IsaacHook/Oscilloscope/README.md

# Oscilloscope
Schematic, PCB, simulation results, firmware and outputs for 20MHz oscilloscope.

#### Front End Desgin
Specification was for an anti-aliasing filter suitable for the 40MSPS maximum sample rate. 
To be implemented with a minimum of a first-order 20dB per decade response and ±2dB maximum ripple in the pass band.
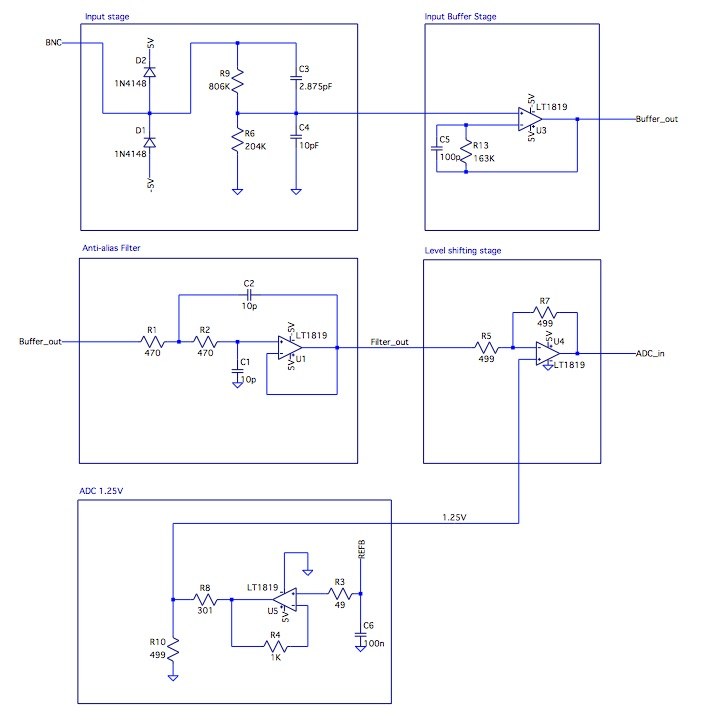
[picture p1: Frontend/frontend.jpg]
  
The plot below shows these specifications were satisfied. A flat response (-13.8 to -13.7dB) can be seen in the pass band, giving a ripple of less than 2dB. 
The 3dB cut-off point is at 20Mhz (-16.5dB) allowing for a maximum sampling rate of 40MSPS. The response can be seen to drop off by 20dB per decade.
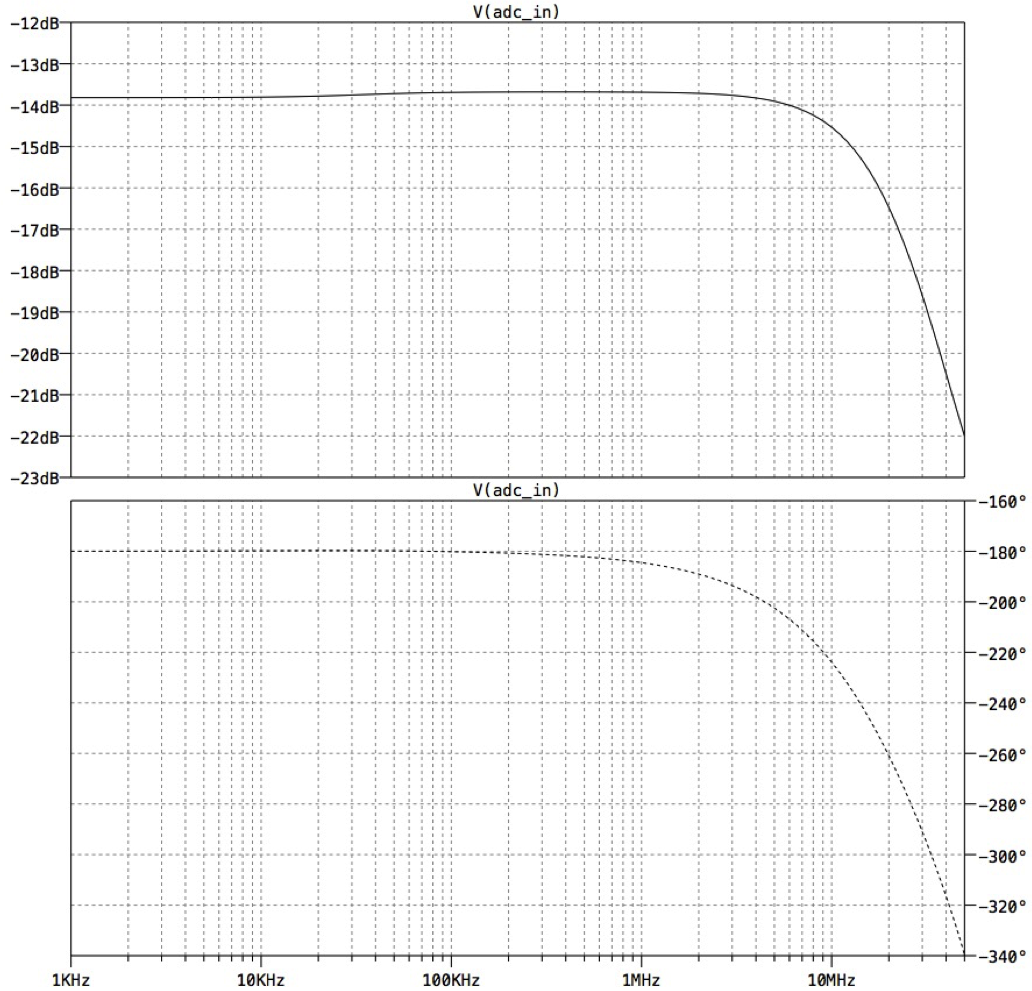
[picture p2: Frontend/adc_input_freq_response.png]


#### Top Sheet
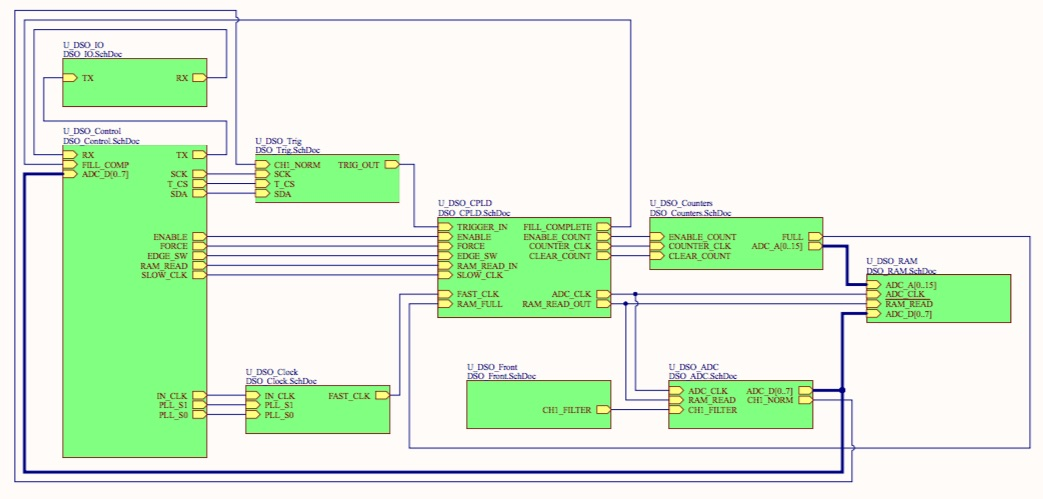
[picture p3: PCB/TopSheet.jpg]


#### PCB
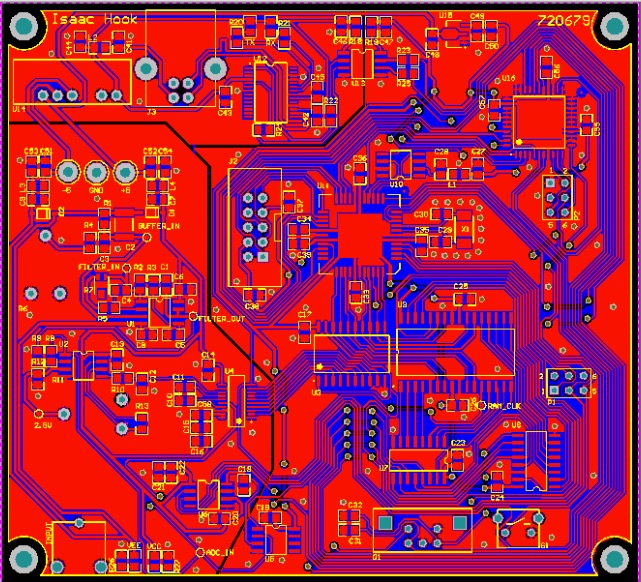
[picture p4: PCB/Top.jpg]


#### PCB 3D
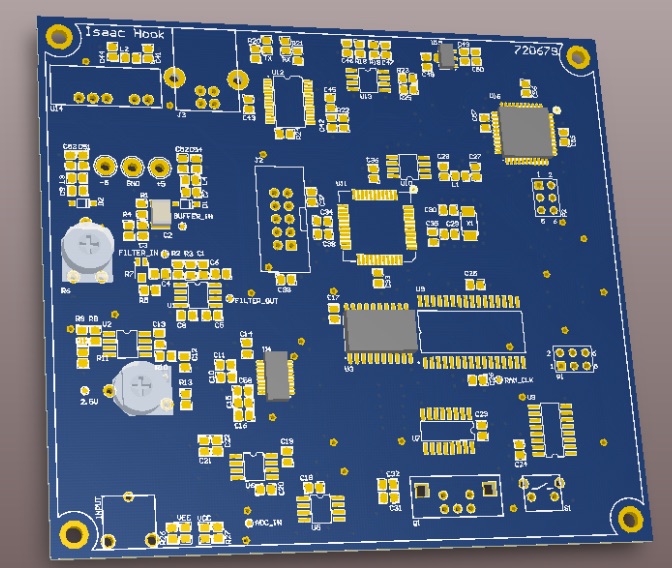
[picture p5: PCB/Top3D.jpg]


#### CPLD design
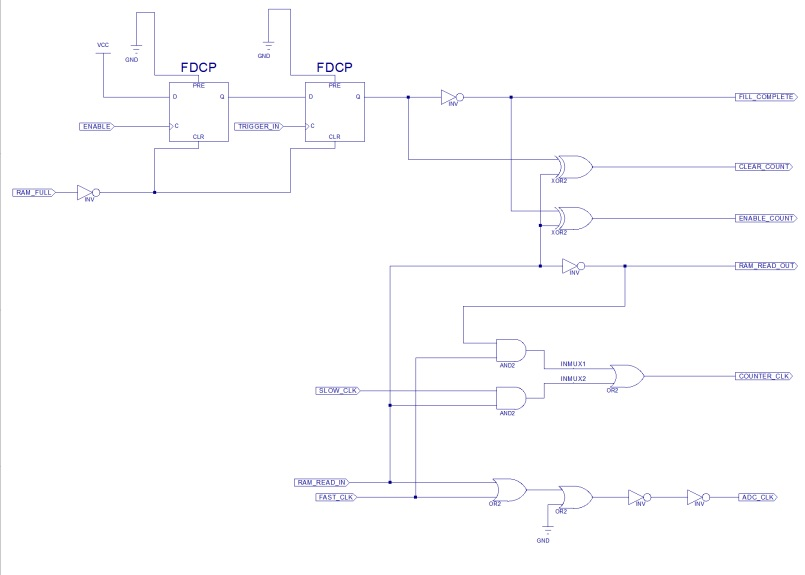
[picture p6: CPLD_debug/dso_outputs_full/Print_Preview.jpg]


#### Final Product
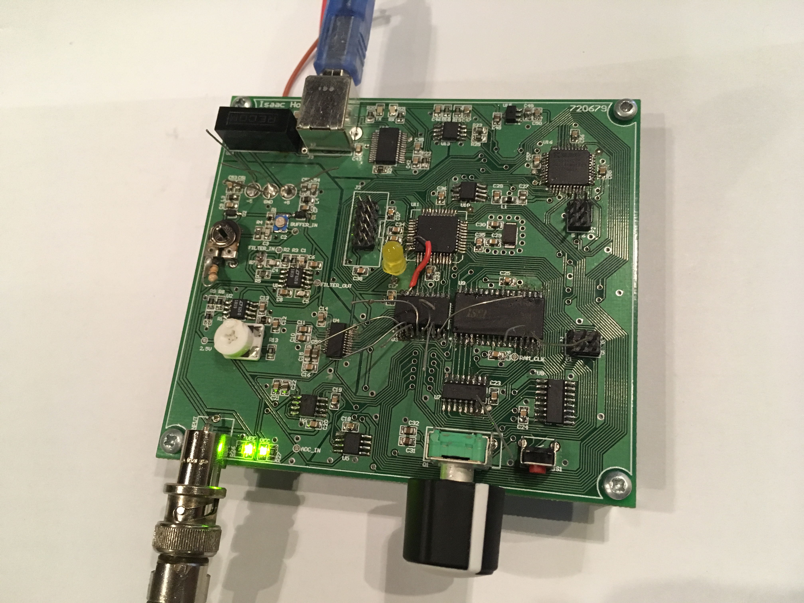
[picture p7: PCB/Final1.JPG]

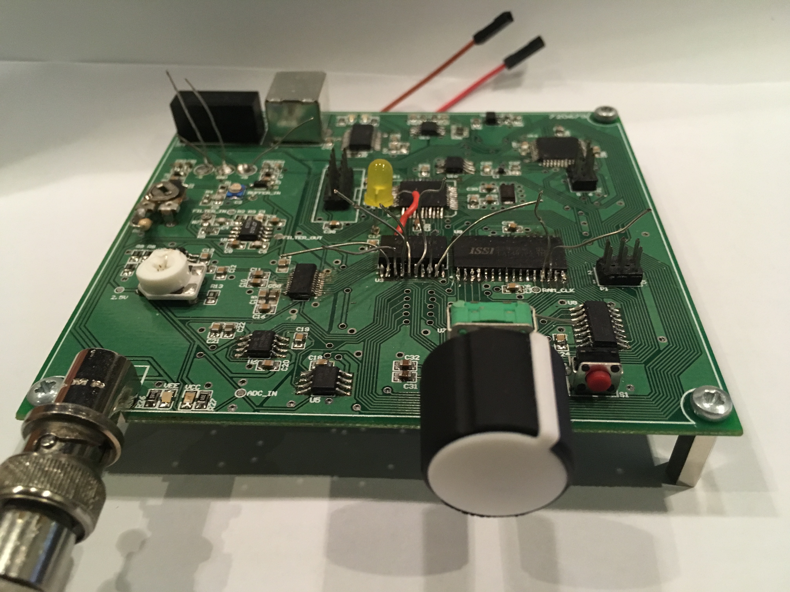
[picture p8: PCB/Final2.JPG]


#### GUI & Output
*Input signal: 50kHz, 2v pk-pk*
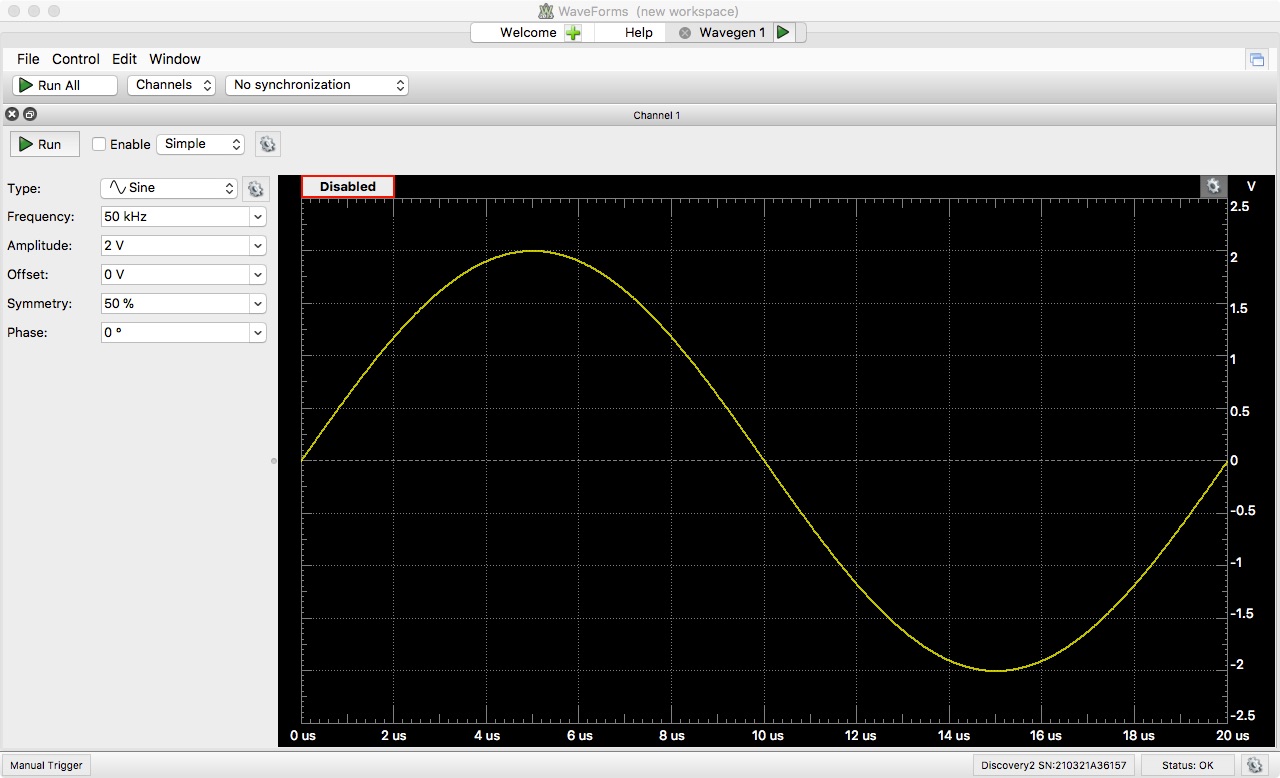
[picture p9: GUI/input.jpg]

*Output signal: 50kHz, 2v pk-pk*
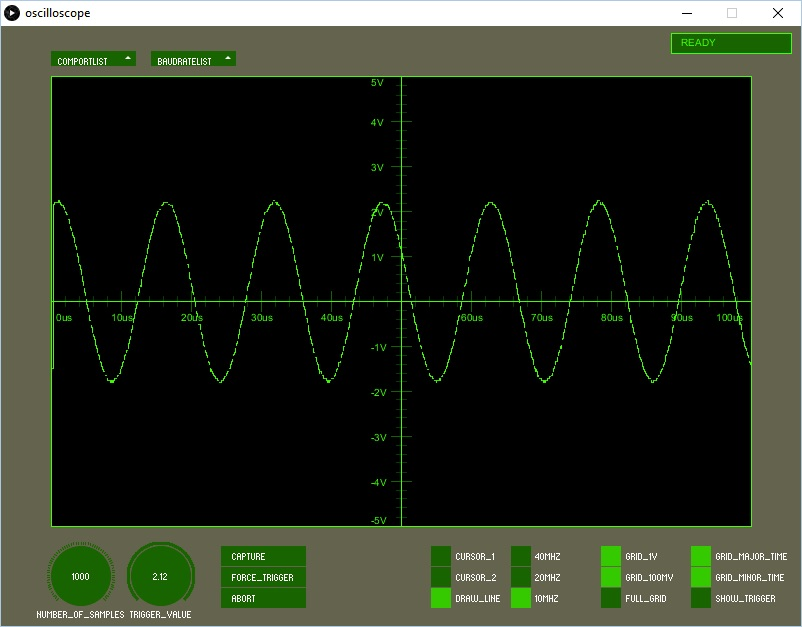
[picture p10: GUI/output.jpg]
