IsaacHook/Oscilloscope/CPLD_debug/dso_outputs_full/ram_read_pad.csv

Release 8.1i - Fit P.20131013
Copyright(c) 1995-2003 Xilinx Inc. All rights reserved
12-17-2017 11:59AM
NOTE: This file is designed to be imported into a spreadsheet program
such as Microsoft Excel for viewing | printing and sorting. The comma ' | '
character is used as the data field separator.
This file is also designed to support parsing.
Input file: ram_read.ngd
output file: ram_read_pad.csv
Part type: xc9536xl
Speed grade: -5
Package: vq44
Pinout by Pin Number:
----- | ----- | ----- | ----- | ----- | ----- | ----- | ----- | ----- | -----
Pin Number | Signal Name | Pin Usage | Pin Name | Direction | IO Standard | IO Bank Number | {blank} | Slew Rate | Termination | {blank} | Voltage | Constraint
P1 | ENABLE | GCK | I/O/GCK3
P2 | TIE |  | I/O
P3 | XLXN_1 | I | I/O | INPUT
P4 | GND |  | GND
P5 | TIE |  | I/O
P6 | RAM_READ_OUT | O | I/O | OUTPUT
P7 | RAM_FULL | I | I/O | INPUT
P8 | TIE |  | I/O
P9 | TDI |  | TDI
P10 | TMS |  | TMS
P11 | TCK |  | TCK
P12 | TRIGGER_IN | I | I/O | INPUT
P13 | TIE |  | I/O
P14 | TIE |  | I/O
P15 | VCC |  | VCCINT
P16 | TIE |  | I/O
P17 | GND |  | GND
P18 | TIE |  | I/O
P19 | TIE |  | I/O
P20 | TIE |  | I/O
P21 | TIE |  | I/O
P22 | TIE |  | I/O
P23 | TIE |  | I/O
P24 | TDO |  | TDO
P25 | GND |  | GND
P26 | VCC |  | VCCIO
P27 | TIE |  | I/O
P28 | FILL_COMPLETE | O | I/O | OUTPUT
P29 | COUNTER_CLK | O | I/O | OUTPUT
P30 | ENABLE_COUNT | O | I/O | OUTPUT
P31 | CLEAR_COUNT | O | I/O | OUTPUT
P32 | TIE |  | I/O
P33 | TIE |  | I/O/GSR
P34 | TIE |  | I/O/GTS2
P35 | VCC |  | VCCINT
P36 | TIE |  | I/O/GTS1
P37 | TIE |  | I/O
P38 | TIE |  | I/O
P39 | TIE |  | I/O
P40 | TIE |  | I/O
P41 | XLXN_2 | O | I/O | OUTPUT
P42 | TIE |  | I/O
P43 | SLOW_CLK | I | I/O/GCK1 | INPUT
P44 | FAST_CLK | I | I/O/GCK2 | INPUT
To preserve the pinout above for future design iterations in
Project Navigator simply execute the (Lock Pins) process
located under the (Implement Design) process in a toolbox named
(Optional Implementation Tools) or invoke PIN2UCF from the
command line. The location constraints will be written into your
specified UCF file
