IsaacHook/Oscilloscope/CPLD_debug/blank/blank_summary.html

blank Project Status (12/07/2017 - 18:16:19)
Project File: | blank.xise | Parser Errors: | No Errors
Module Name: | blank | Implementation State: | Fitted
Target Device: | xc9536xl-5VQ44 | Errors: | No Errors
Product Version: | ISE 14.7 | Warnings: | 1 Warning (1 new)
Design Goal: | Balanced | Routing Results:
Design Strategy: | Xilinx Default (unlocked) | Timing Constraints:
Environment: | System Settings | Final Timing Score:

Detailed Reports | | | | | | [-]
Report Name | Status | Generated | Errors | Warnings | Infos
Synthesis Report | Current | Thu 7. Dec 18:15:35 2017 | 0 | 1 Warning (1 new) | 0
Translation Report | Current | Thu 7. Dec 18:15:50 2017 | 0 | 0 | 0
CPLD Fitter Report (Text) | Current | Thu 7. Dec 18:15:58 2017 | 0 | 2 Warnings (1 new) | 1 Info (1 new)
Power Report

Secondary Reports | | | [-]
Report Name | Status | Generated
IBIS Model | Out of Date | Wed 6. Dec 08:44:48 2017
Post-Fit Simulation Model Report

Date Generated: 12/07/2017 - 18:19:26
