IsaacHook/Oscilloscope/CPLD_debug/blank/in_out_summary.html

blank Project Status (12/07/2017 - 18:16:19)
Project File: | blank.xise | Parser Errors: | No Errors
Module Name: | blank | Implementation State: | Fitted
Target Device: | xc9536xl-5VQ44 | Errors:
Product Version: | ISE 14.7 | Warnings:
Design Goal: | Balanced | Routing Results:
Design Strategy: | Xilinx Default (unlocked) | Timing Constraints:
Environment: | System Settings | Final Timing Score:

Detailed Reports | | | | | | [-]
Report Name | Status | Generated | Errors | Warnings | Infos
Synthesis Report | Current | Thu 7. Dec 18:23:12 2017
Translation Report | Current | Thu 7. Dec 19:02:07 2017 | 0 | 0 | 0
CPLD Fitter Report (Text) | Current | Thu 7. Dec 19:02:46 2017 | 0 | 2 Warnings (1 new) | 1 Info (1 new)
Power Report

Secondary Reports | | | [-]
Report Name | Status | Generated
Post-Fit Simulation Model Report

Date Generated: 12/17/2017 - 09:02:30
