IsaacHook/Oscilloscope/CPLD_debug/dso_outputs/CPLD_top_summary.html

CPLD_top Project Status (12/17/2017 - 11:41:02)
Project File: | dso_outputs.xise | Parser Errors: | No Errors
Module Name: | CPLD_top | Implementation State: | Translated
Target Device: | xc9536xl-5VQ44 | Errors: | No Errors
Product Version: | ISE 14.7 | Warnings: | No Warnings
Design Goal: | Balanced | Routing Results:
Design Strategy: | Xilinx Default (unlocked) | Timing Constraints:
Environment: | System Settings | Final Timing Score:

Detailed Reports | | | | | | [-]
Report Name | Status | Generated | Errors | Warnings | Infos
Synthesis Report | Current | Sun 17. Dec 11:40:46 2017 | 0 | 0 | 0
Translation Report | Current | Sun 17. Dec 11:40:59 2017 | 0 | 0 | 0
CPLD Fitter Report (Text) | Out of Date | Sun 17. Dec 11:13:26 2017 | 0 | 4 Warnings (1 new) | 3 Infos (3 new)
Power Report

Secondary Reports | | | [-]
Report Name | Status | Generated
Post-Fit Simulation Model Report

Date Generated: 12/17/2017 - 11:41:02
