IsaacHook/Oscilloscope/CPLD_debug/dso_outputs_full/ram_read_summary.html

ram_read Project Status (12/17/2017 - 11:59:34)
Project File: | dso_outputs_full.xise | Parser Errors: | No Errors
Module Name: | ram_read | Implementation State: | Fitted
Target Device: | xc9536xl-5VQ44 | Errors: | No Errors
Product Version: | ISE 14.7 | Warnings: | No Warnings
Design Goal: | Balanced | Routing Results:
Design Strategy: | Xilinx Default (unlocked) | Timing Constraints:
Environment: | System Settings | Final Timing Score:

Detailed Reports | | | | | | [-]
Report Name | Status | Generated | Errors | Warnings | Infos
Synthesis Report | Current | Sun 17. Dec 11:59:01 2017 | 0 | 0 | 0
Translation Report | Current | Sun 17. Dec 11:59:11 2017 | 0 | 0 | 0
CPLD Fitter Report (Text) | Current | Sun 17. Dec 11:59:17 2017 | 0 | 3 Warnings (2 new) | 3 Infos (3 new)
Power Report

Secondary Reports | | | [-]
Report Name | Status | Generated
Post-Fit Simulation Model Report

Date Generated: 12/17/2017 - 11:59:34
