IsaacHook/Oscilloscope/CPLD_debug/dso_outputs_new/CPLD_top_summary.html

CPLD_top Project Status (12/17/2017 - 11:11:16)
Project File: | dso_outputs_new.xise | Parser Errors: | No Errors
Module Name: | CPLD_top | Implementation State: | Fitted
Target Device: | xc9536xl-5VQ44 | Errors: | No Errors
Product Version: | ISE 14.7 | Warnings: | 1 Warning (1 new)
Design Goal: | Balanced | Routing Results:
Design Strategy: | Xilinx Default (unlocked) | Timing Constraints:
Environment: | System Settings | Final Timing Score:

Detailed Reports | | | | | | [-]
Report Name | Status | Generated | Errors | Warnings | Infos
Synthesis Report | Current | Sun 17. Dec 11:09:31 2017 | 0 | 1 Warning (1 new) | 0
Translation Report | Current | Sun 17. Dec 11:10:51 2017 | 0 | 0 | 0
CPLD Fitter Report (Text) | Current | Sun 17. Dec 11:10:56 2017 | 0 | 4 Warnings (1 new) | 3 Infos (3 new)
Power Report

Secondary Reports | | | [-]
Report Name | Status | Generated
Post-Fit Simulation Model Report

Date Generated: 12/17/2017 - 11:11:16
