IsaacHook/Oscilloscope/CPLD_debug/or_gate/or_gate_summary.html

or_gate Project Status
Project File: | or_gate.xise | Parser Errors: | No Errors
Module Name: | or_gate | Implementation State: | Synthesized
Target Device: | xc9536xl-5VQ44 | Errors: | X 1 Error (0 new)
Product Version: | ISE 14.7 | Warnings: | No Warnings
Design Goal: | Balanced | Routing Results:
Design Strategy: | Xilinx Default (unlocked) | Timing Constraints:
Environment: | System Settings | Final Timing Score:

Detailed Reports | | | | | | [-]
Report Name | Status | Generated | Errors | Warnings | Infos
Synthesis Report | Current | Wed 6. Dec 08:26:21 2017 | X 1 Error (0 new) | 0 | 0
Translation Report | Out of Date | Tue 5. Dec 22:55:36 2017 | X 1 Error (0 new) | 0 | 0
CPLD Fitter Report (Text) | Out of Date | Tue 5. Dec 19:13:04 2017 | 0 | 1 Warning (1 new) | 0
Power Report

Secondary Reports | | | [-]
Report Name | Status | Generated
Post-Fit Simulation Model Report

Date Generated: 12/17/2017 - 09:38:35
