IsaacHook/Oscilloscope/CPLD_debug/output_high/output_high_summary.html

output_high Project Status (12/08/2017 - 15:31:18)
Project File: | output_high.xise | Parser Errors: | No Errors
Module Name: | output_high | Implementation State: | Fitted
Target Device: | xc9536xl-5VQ44 | Errors: | No Errors
Product Version: | ISE 14.7 | Warnings: | No Warnings
Design Goal: | Balanced | Routing Results:
Design Strategy: | Xilinx Default (unlocked) | Timing Constraints:
Environment: | System Settings | Final Timing Score:

Detailed Reports | | | | | | [-]
Report Name | Status | Generated | Errors | Warnings | Infos
Synthesis Report | Current | Fri 8. Dec 15:46:30 2017 | 0 | 0 | 0
Translation Report | Current | Fri 8. Dec 15:46:44 2017 | 0 | 0 | 0
CPLD Fitter Report (Text) | Current | Fri 8. Dec 15:46:50 2017 | 0 | 2 Warnings (1 new) | 1 Info (1 new)
Power Report

Secondary Reports | | | [-]
Report Name | Status | Generated
Post-Fit Simulation Model Report

Date Generated: 12/08/2017 - 15:49:39
