IsaacHook/Oscilloscope/CPLD_debug/blank/blank_envsettings.html

System Settings

Environment Settings
Environment Variable | xst | ngdbuild
PATHEXT | .COM; .EXE; .BAT; .CMD; .VBS; .VBE; .JS; .JSE; .WSF; .WSH; .MSC | .COM; .EXE; .BAT; .CMD; .VBS; .VBE; .JS; .JSE; .WSF; .WSH; .MSC

Path

C:\Xilinx\14.7\ISE_DS\ISE\\lib\nt64;
C:\Xilinx\14.7\ISE_DS\ISE\\bin\nt64;
C:\Xilinx\14.7\ISE_DS\ISE\bin\nt64;
C:\Xilinx\14.7\ISE_DS\ISE\lib\nt64;
C:\Xilinx\14.7\ISE_DS\ISE\..\..\..\DocNav;
C:\Xilinx\14.7\ISE_DS\PlanAhead\bin;
C:\Xilinx\14.7\ISE_DS\EDK\bin\nt64;
C:\Xilinx\14.7\ISE_DS\EDK\lib\nt64;
C:\Xilinx\14.7\ISE_DS\EDK\gnu\microblaze\nt\bin;
C:\Xilinx\14.7\ISE_DS\EDK\gnu\powerpc-eabi\nt\bin;
C:\Xilinx\14.7\ISE_DS\EDK\gnuwin\bin;
C:\Xilinx\14.7\ISE_DS\EDK\gnu\arm\nt\bin;
C:\Xilinx\14.7\ISE_DS\EDK\gnu\microblaze\linux_toolchain\nt64_be\bin;
C:\Xilinx\14.7\ISE_DS\EDK\gnu\microblaze\linux_toolchain\nt64_le\bin;
C:\Xilinx\14.7\ISE_DS\common\bin\nt64;
C:\Xilinx\14.7\ISE_DS\common\lib\nt64;
C:\Program Files (x86)\Parallels\Parallels Tools\Applications;
C:\WINDOWS\system32;
C:\WINDOWS;
C:\WINDOWS\System32\Wbem;
C:\WINDOWS\System32\WindowsPowerShell\v1.0\;
C:\WinAVR-20100110\bin;
C:\WinAVR-20100110\utils\bin;
C:\Program Files\PuTTY\;
C:\Users\Isaac\AppData\Local\Microsoft\WindowsApps

C:\Xilinx\14.7\ISE_DS\ISE\\lib\nt64;
C:\Xilinx\14.7\ISE_DS\ISE\\bin\nt64;
C:\Xilinx\14.7\ISE_DS\ISE\bin\nt64;
C:\Xilinx\14.7\ISE_DS\ISE\lib\nt64;
C:\Xilinx\14.7\ISE_DS\ISE\..\..\..\DocNav;
C:\Xilinx\14.7\ISE_DS\PlanAhead\bin;
C:\Xilinx\14.7\ISE_DS\EDK\bin\nt64;
C:\Xilinx\14.7\ISE_DS\EDK\lib\nt64;
C:\Xilinx\14.7\ISE_DS\EDK\gnu\microblaze\nt\bin;
C:\Xilinx\14.7\ISE_DS\EDK\gnu\powerpc-eabi\nt\bin;
C:\Xilinx\14.7\ISE_DS\EDK\gnuwin\bin;
C:\Xilinx\14.7\ISE_DS\EDK\gnu\arm\nt\bin;
C:\Xilinx\14.7\ISE_DS\EDK\gnu\microblaze\linux_toolchain\nt64_be\bin;
C:\Xilinx\14.7\ISE_DS\EDK\gnu\microblaze\linux_toolchain\nt64_le\bin;
C:\Xilinx\14.7\ISE_DS\common\bin\nt64;
C:\Xilinx\14.7\ISE_DS\common\lib\nt64;
C:\Program Files (x86)\Parallels\Parallels Tools\Applications;
C:\WINDOWS\system32;
C:\WINDOWS;
C:\WINDOWS\System32\Wbem;
C:\WINDOWS\System32\WindowsPowerShell\v1.0\;
C:\WinAVR-20100110\bin;
C:\WinAVR-20100110\utils\bin;
C:\Program Files\PuTTY\;
C:\Users\Isaac\AppData\Local\Microsoft\WindowsApps
XILINX | C:\Xilinx\14.7\ISE_DS\ISE\ | C:\Xilinx\14.7\ISE_DS\ISE\
XILINX_DSP | C:\Xilinx\14.7\ISE_DS\ISE | C:\Xilinx\14.7\ISE_DS\ISE
XILINX_EDK | C:\Xilinx\14.7\ISE_DS\EDK | C:\Xilinx\14.7\ISE_DS\EDK
XILINX_PLANAHEAD | C:\Xilinx\14.7\ISE_DS\PlanAhead | C:\Xilinx\14.7\ISE_DS\PlanAhead

Synthesis Property Settings
Switch Name | Property Name | Value | Default Value
-ifn | | blank.prj
-ifmt | | mixed | MIXED
-ofn | | blank
-ofmt | | NGC | NGC
-p | | xc9500xl
-top | | blank
-opt_mode | Optimization Goal | Speed | SPEED
-opt_level | Optimization Effort | 1 | 1
-iuc | Use synthesis Constraints File | NO | NO
-keep_hierarchy | Keep Hierarchy | Yes | YES
-netlist_hierarchy | Netlist Hierarchy | As_Optimized | as_optimized
-rtlview | Generate RTL Schematic | Yes | NO
-bus_delimiter | Bus Delimiter | <> | <>
-verilog2001 | Verilog 2001 | YES | YES
-fsm_extract | | YES | YES
-fsm_encoding | | Auto | AUTO
-safe_implementation | | No | NO
-resource_sharing | | YES | YES
-iobuf | | YES | YES
-equivalent_register_removal | | YES | YES

Translation Property Settings
Switch Name | Property Name | Value | Default Value
-intstyle | | ise | None
-dd | | _ngo | None
-p | | xc9536xl-VQ44-5 | None
-uc | | blank.ucf | None

Operating System Information
Operating System Information | xst | ngdbuild
CPU Architecture/Speed | Intel(R) Core(TM)2 Duo CPU P8600 @ 2.40GHz/2389 MHz | Intel(R) Core(TM)2 Duo CPU P8600 @ 2.40GHz/2389 MHz
Host | ISAACHOOK3575 | ISAACHOOK3575
OS Name | Microsoft , 64-bit | Microsoft , 64-bit
OS Release | major release (build 9200) | major release (build 9200)
