IsaacHook/Oscilloscope/PCB/Schematics.pdf

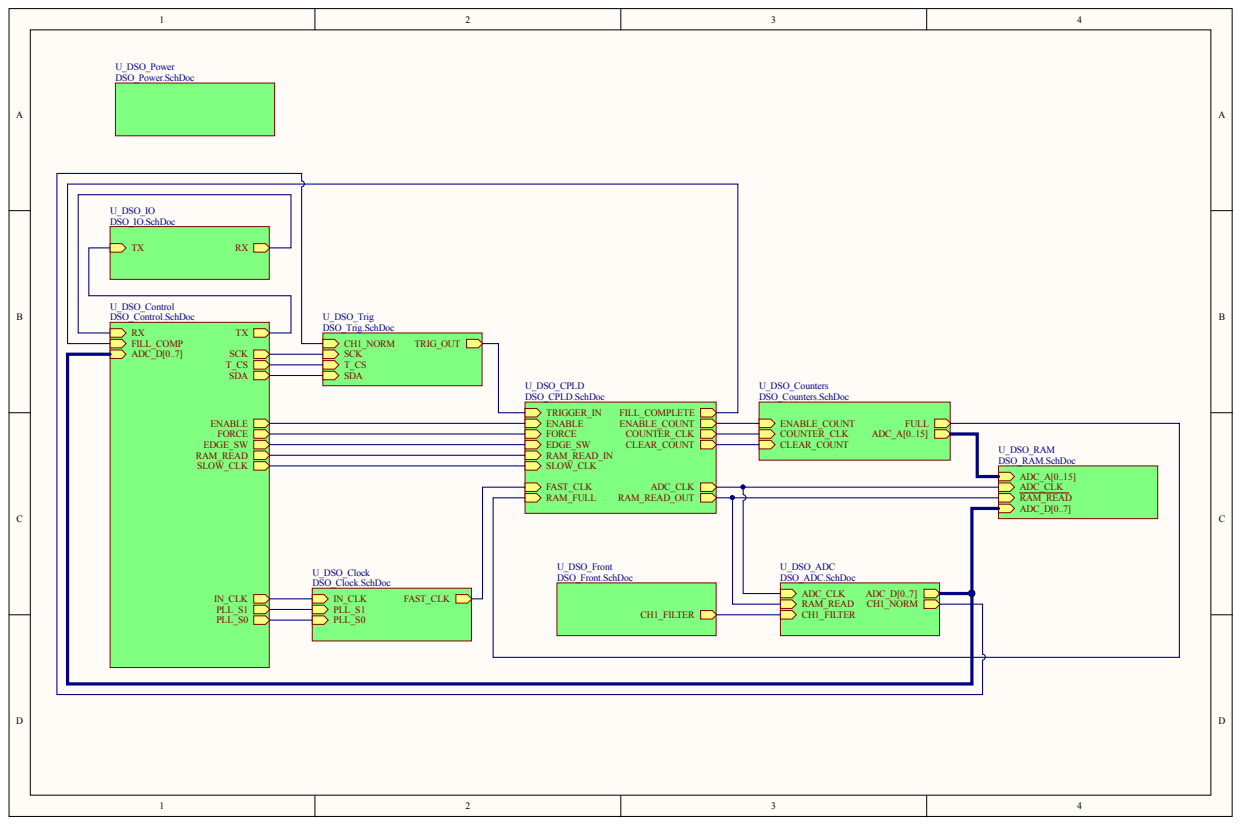
[picture p28: page 1]

U_DSO_ADC DSO_ADC.SchDoc

CH1_FILTER | ADC_CLK ADC_D[0..7] RAM_READ CH1_NORM CH1_FILTER

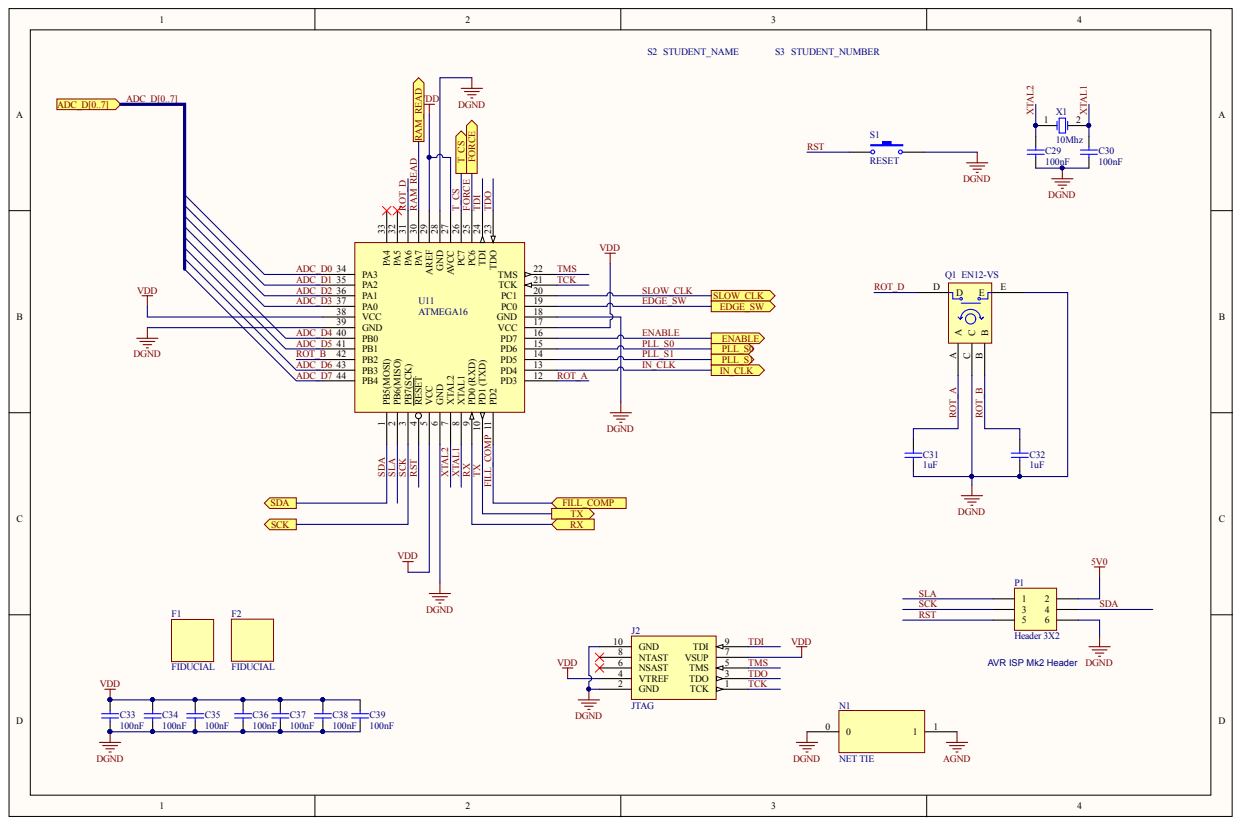
[picture p29: page 2]

22 DO 23 TDI 24 PC6 25 PC7 26 AVCC 27 GND 28 AREF 29 PA7 30 PA6 31 PA5 32 PA4 33

PD2 11 PD3 12 PD4 13 PD5 14 PD6 15 PD7 16 VCC 17 GND 18 PC0 19 PC1 20 TCK 21 TMS

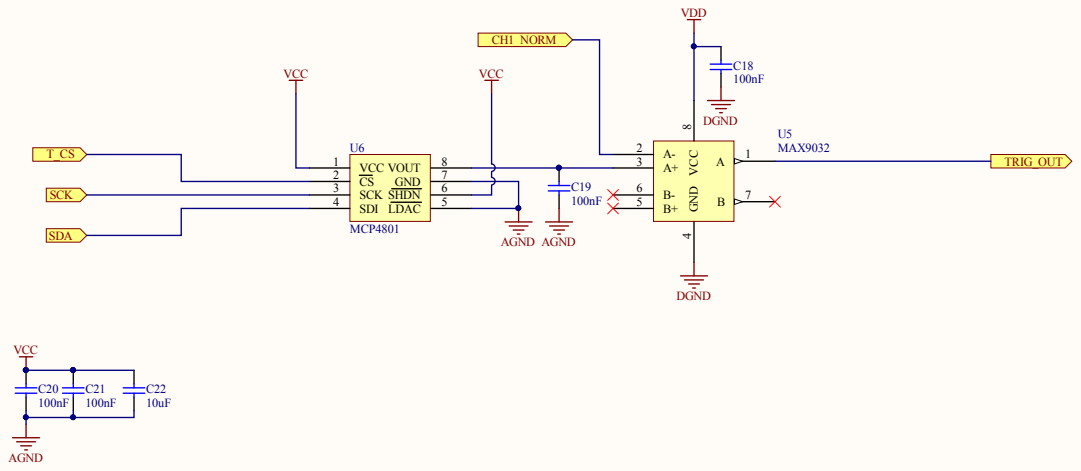
[picture p30: page 3]

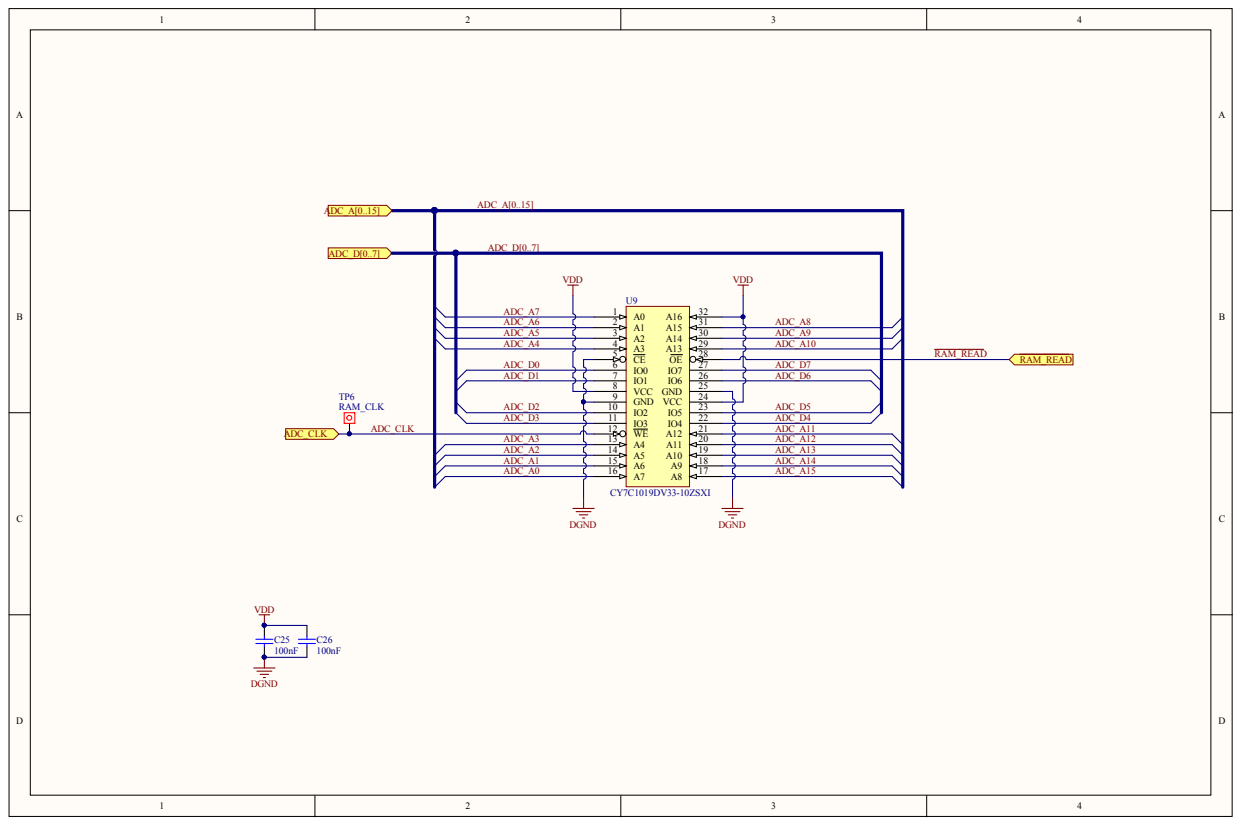
[picture p31: page 4]

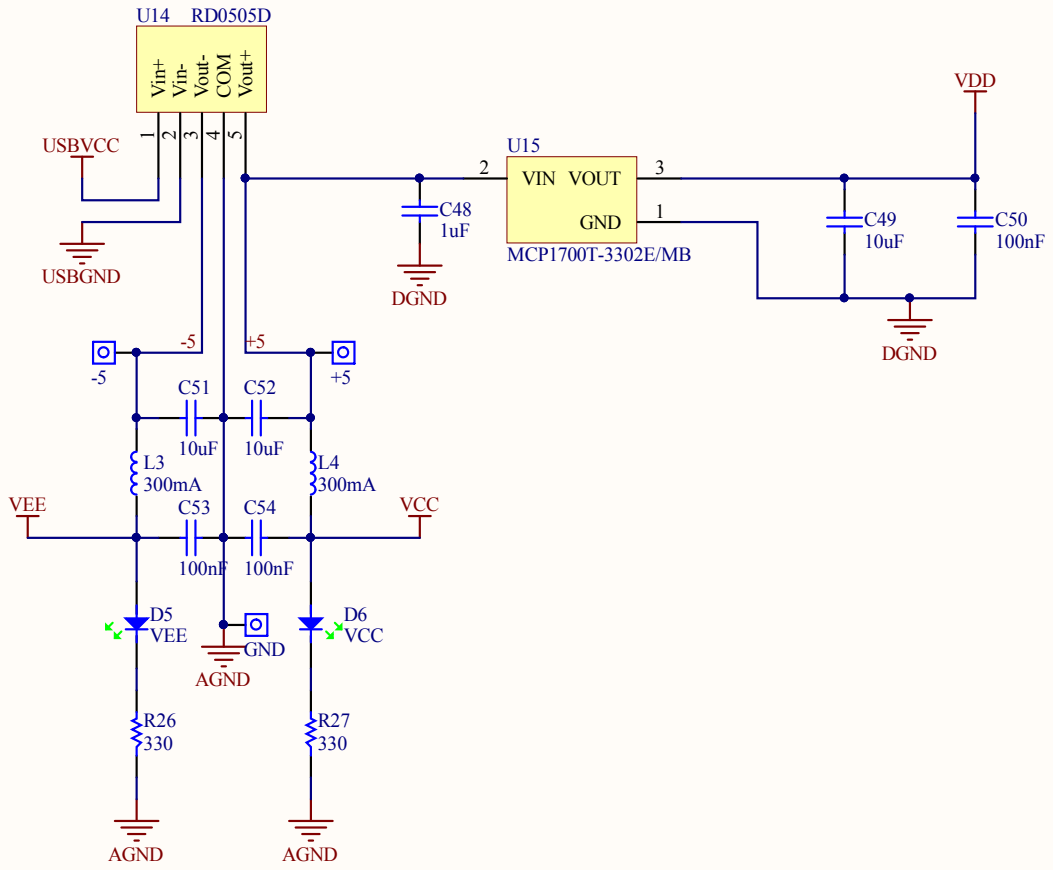
[picture p32: page 5]

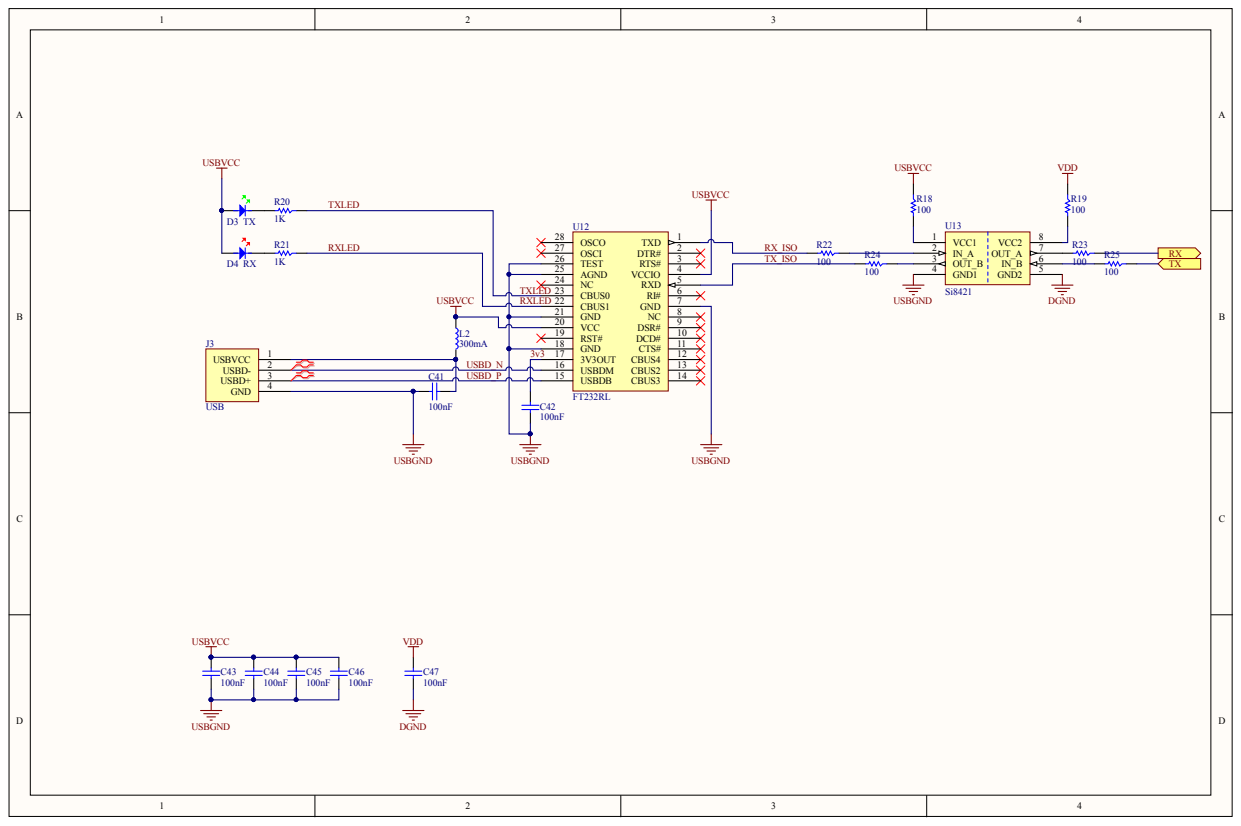
[picture p33: page 6]

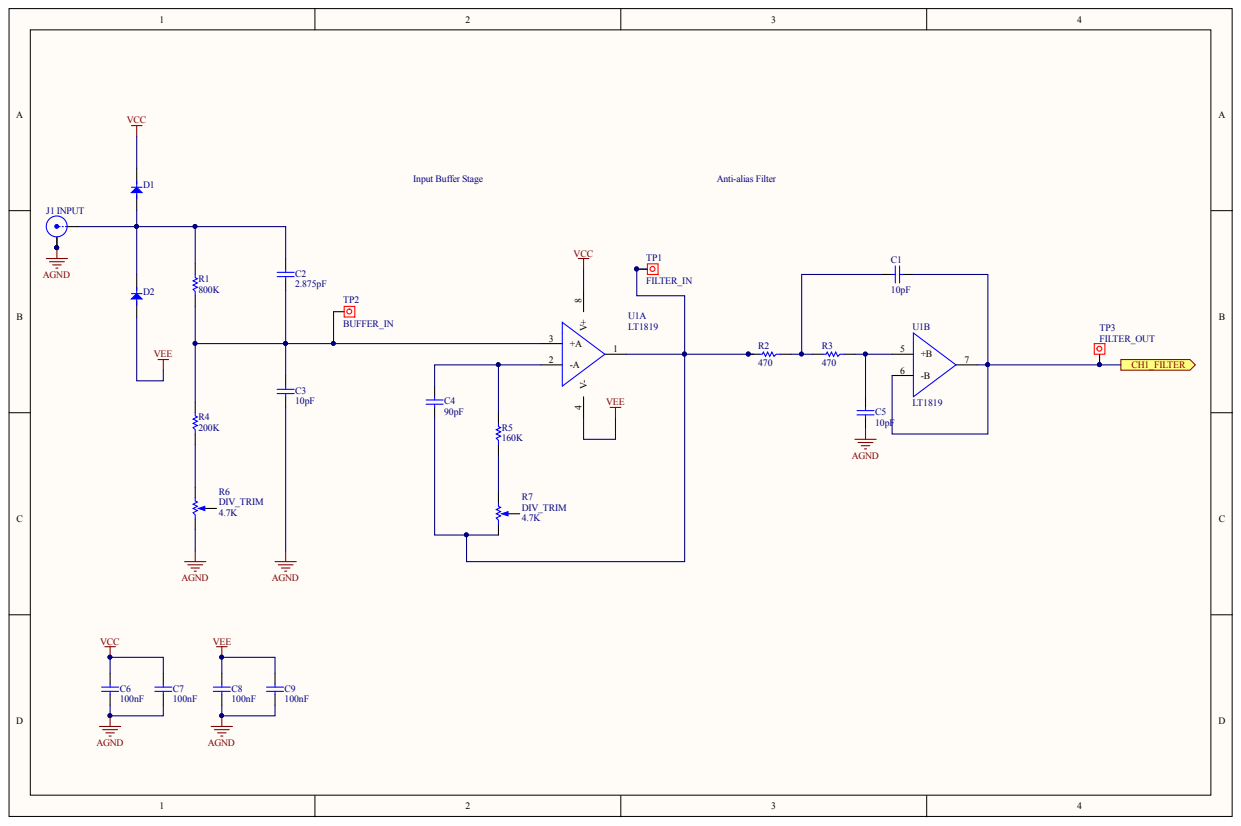
[picture p34: page 7]

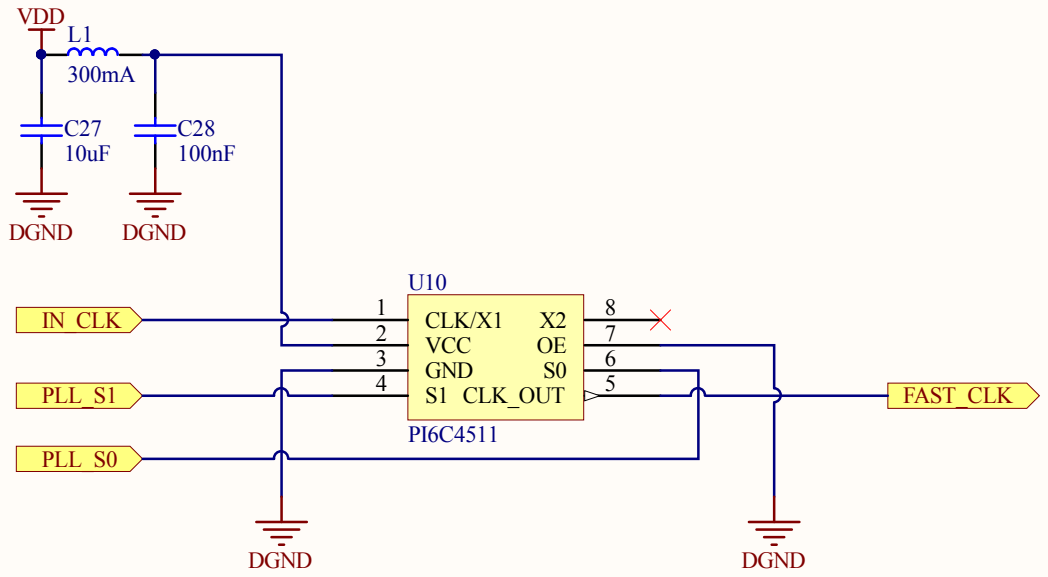
[picture p35: page 8]

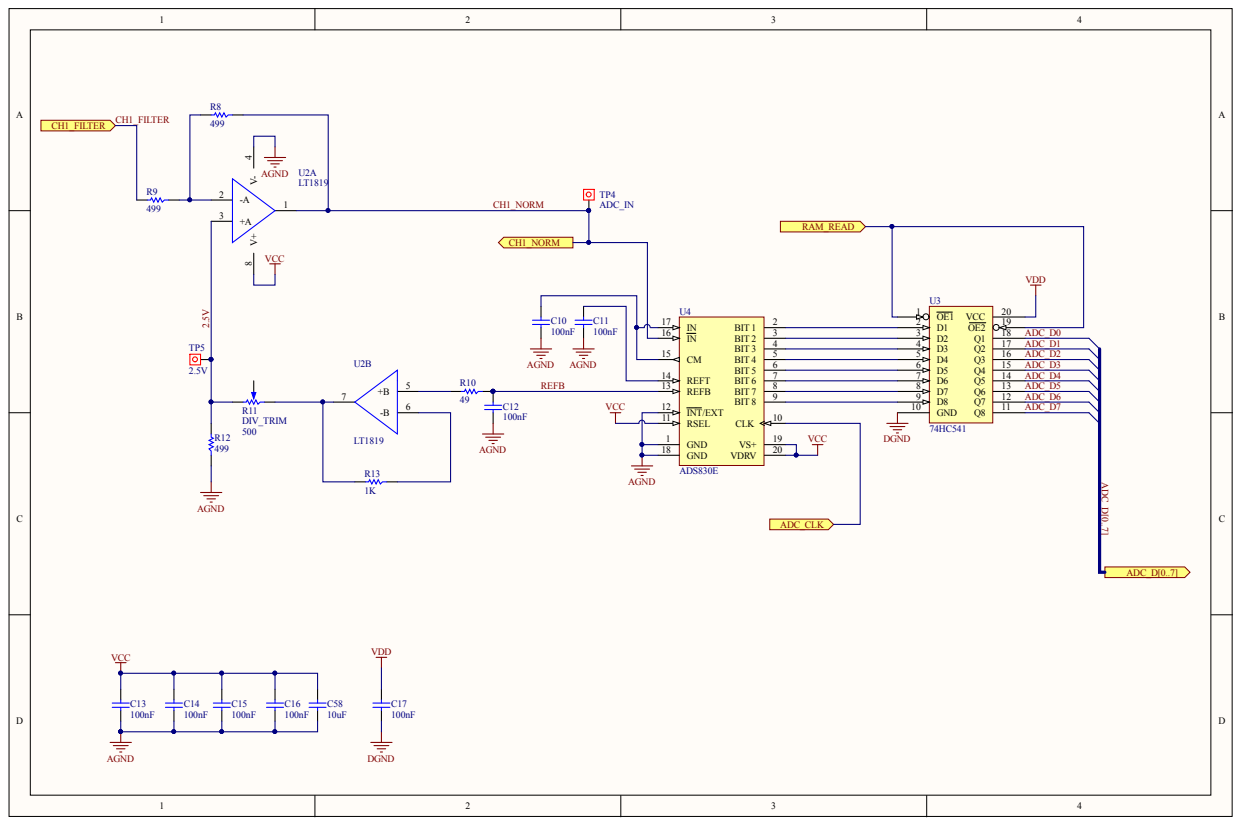
[picture p36: page 9]

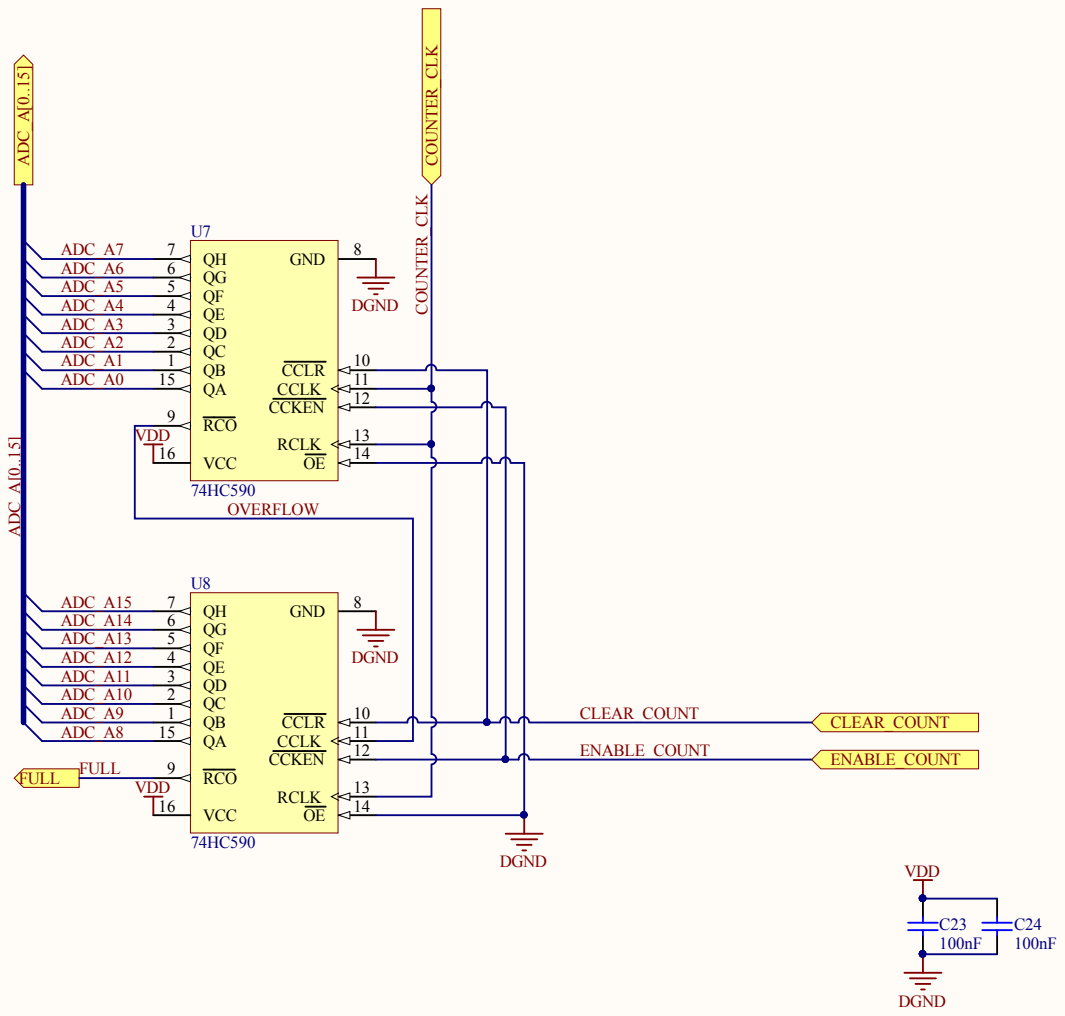
[picture p37: page 10]

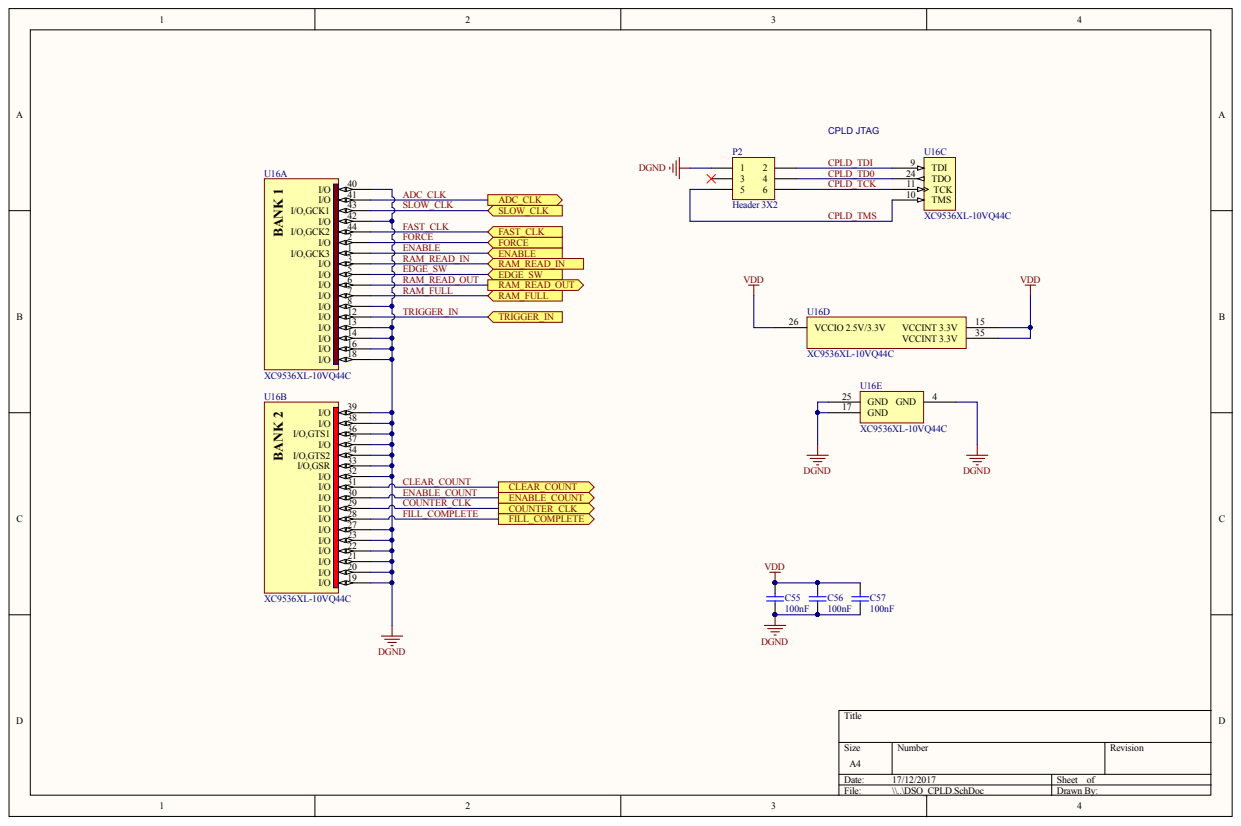
[picture p38: page 11]

Numbe r | R evision

: 17/12/2017 | She et of
File : \\. .\D S O_C PLD . S chDoc | D r awn By:
