IsaacHook/Oscilloscope/Frontend/frontend.asc

C1: cap; 10p
C2: cap; 10p
C3: cap; 2.875pF
C4: cap; 10pF
C5: cap; 100p
C6: cap; 100n
D1: diode; 1N4148
D2: diode; 1N4148
D3: diode; 1N4148
D4: diode; 1N4148
R1: res; 470
R2: res; 470
R3: res; 49
R4: res; 1K
R5: res; 499
R6: res; 204K
R7: res; 499
R8: res; 301
R9: res; 806K
R10: res; 499
R13: res; 163K
U1: LT1819
U2: LT1819
U3: LT1819
U4: LT1819
U5: LT1819
V2: voltage; 5V
V3: voltage; 5V
V5: voltage; 3V
V6: voltage; 2V
V10: voltage; SINE(0 5 1); AC 1 0
Vin: voltage; SINE(0 5 1MEG); AC 1 0
Named nets: 0, 5V, -5V, REFB, REFT, Buffer_out, BNC, Buffer_in, Filter_out, 1.25V, ADC_in
.tran 0 15u
Anti-alias Filter
Input Buffer Stage
Input stage
.ac dec 100 1K 500MEG
Level shifting stage
Impedance and frequency response
ADC 1.25V
