IsaacHook/Oscilloscope/CPLD_debug/blank/blank.vhd

--------------------------------------------------------------------------------
-- Copyright (c) 1995-2013 Xilinx, Inc.  All rights reserved.
--------------------------------------------------------------------------------
--   ____  ____ 
--  /   /\/   / 
-- /___/  \  /    Vendor: Xilinx 
-- \   \   \/     Version : 14.7
--  \   \         Application : sch2hdl
--  /   /         Filename : blank.vhf
-- /___/   /\     Timestamp : 12/06/2017 09:13:20
-- \   \  /  \ 
--  \___\/\___\ 
--
--Command: sch2hdl -intstyle ise -family xc9500xl -flat -suppress -vhdl Z:/Desktop/DSO/CPLD_debug/blank/blank.vhf -w Z:/Desktop/DSO/CPLD_debug/blank/blank.sch
--Design Name: blank
--Device: xc9500xl
--Purpose:
--    This vhdl netlist is translated from an ECS schematic. It can be 
--    synthesized and simulated, but it should not be modified. 
--

library ieee;
use ieee.std_logic_1164.ALL;
use ieee.numeric_std.ALL;
library UNISIM;
use UNISIM.Vcomponents.ALL;

entity blank is
   port ( XLXN_2 : in    std_logic; 
          XLXN_3 : out   std_logic);
end blank;

architecture BEHAVIORAL of blank is
   attribute BOX_TYPE   : string ;
   component BUF
      port ( I : in    std_logic; 
             O : out   std_logic);
   end component;
   attribute BOX_TYPE of BUF : component is "BLACK_BOX";
   
begin
   XLXI_2 : BUF
      port map (I=>XLXN_2,
                O=>XLXN_3);
   
end BEHAVIORAL;
