IsaacHook/Oscilloscope/CPLD_debug/blank/in_out.vhd

----------------------------------------------------------------------------------
-- Company: 
-- Engineer: 
-- 
-- Create Date:    18:19:25 12/07/2017 
-- Design Name: 
-- Module Name:    in_out - Behavioral 
-- Project Name: 
-- Target Devices: 
-- Tool versions: 
-- Description: 
--
-- Dependencies: 
--
-- Revision: 
-- Revision 0.01 - File Created
-- Additional Comments: 
--
----------------------------------------------------------------------------------
library IEEE;
use IEEE.STD_LOGIC_1164.ALL;

-- Uncomment the following library declaration if using
-- arithmetic functions with Signed or Unsigned values
--use IEEE.NUMERIC_STD.ALL;

-- Uncomment the following library declaration if instantiating
-- any Xilinx primitives in this code.
--library UNISIM;
--use UNISIM.VComponents.all;

entity in_out is
    Port ( in1 : in  STD_LOGIC;
           out1 : out  STD_LOGIC);
end in_out;

architecture Behavioral of in_out is

begin
out1 <= in1;
end Behavioral;
